KarthikKurapati/Keyboard-75/hardware/Keyboard.kicad_pcb

## KiCad design hardware/Keyboard.kicad_pcb (2026-01-09)

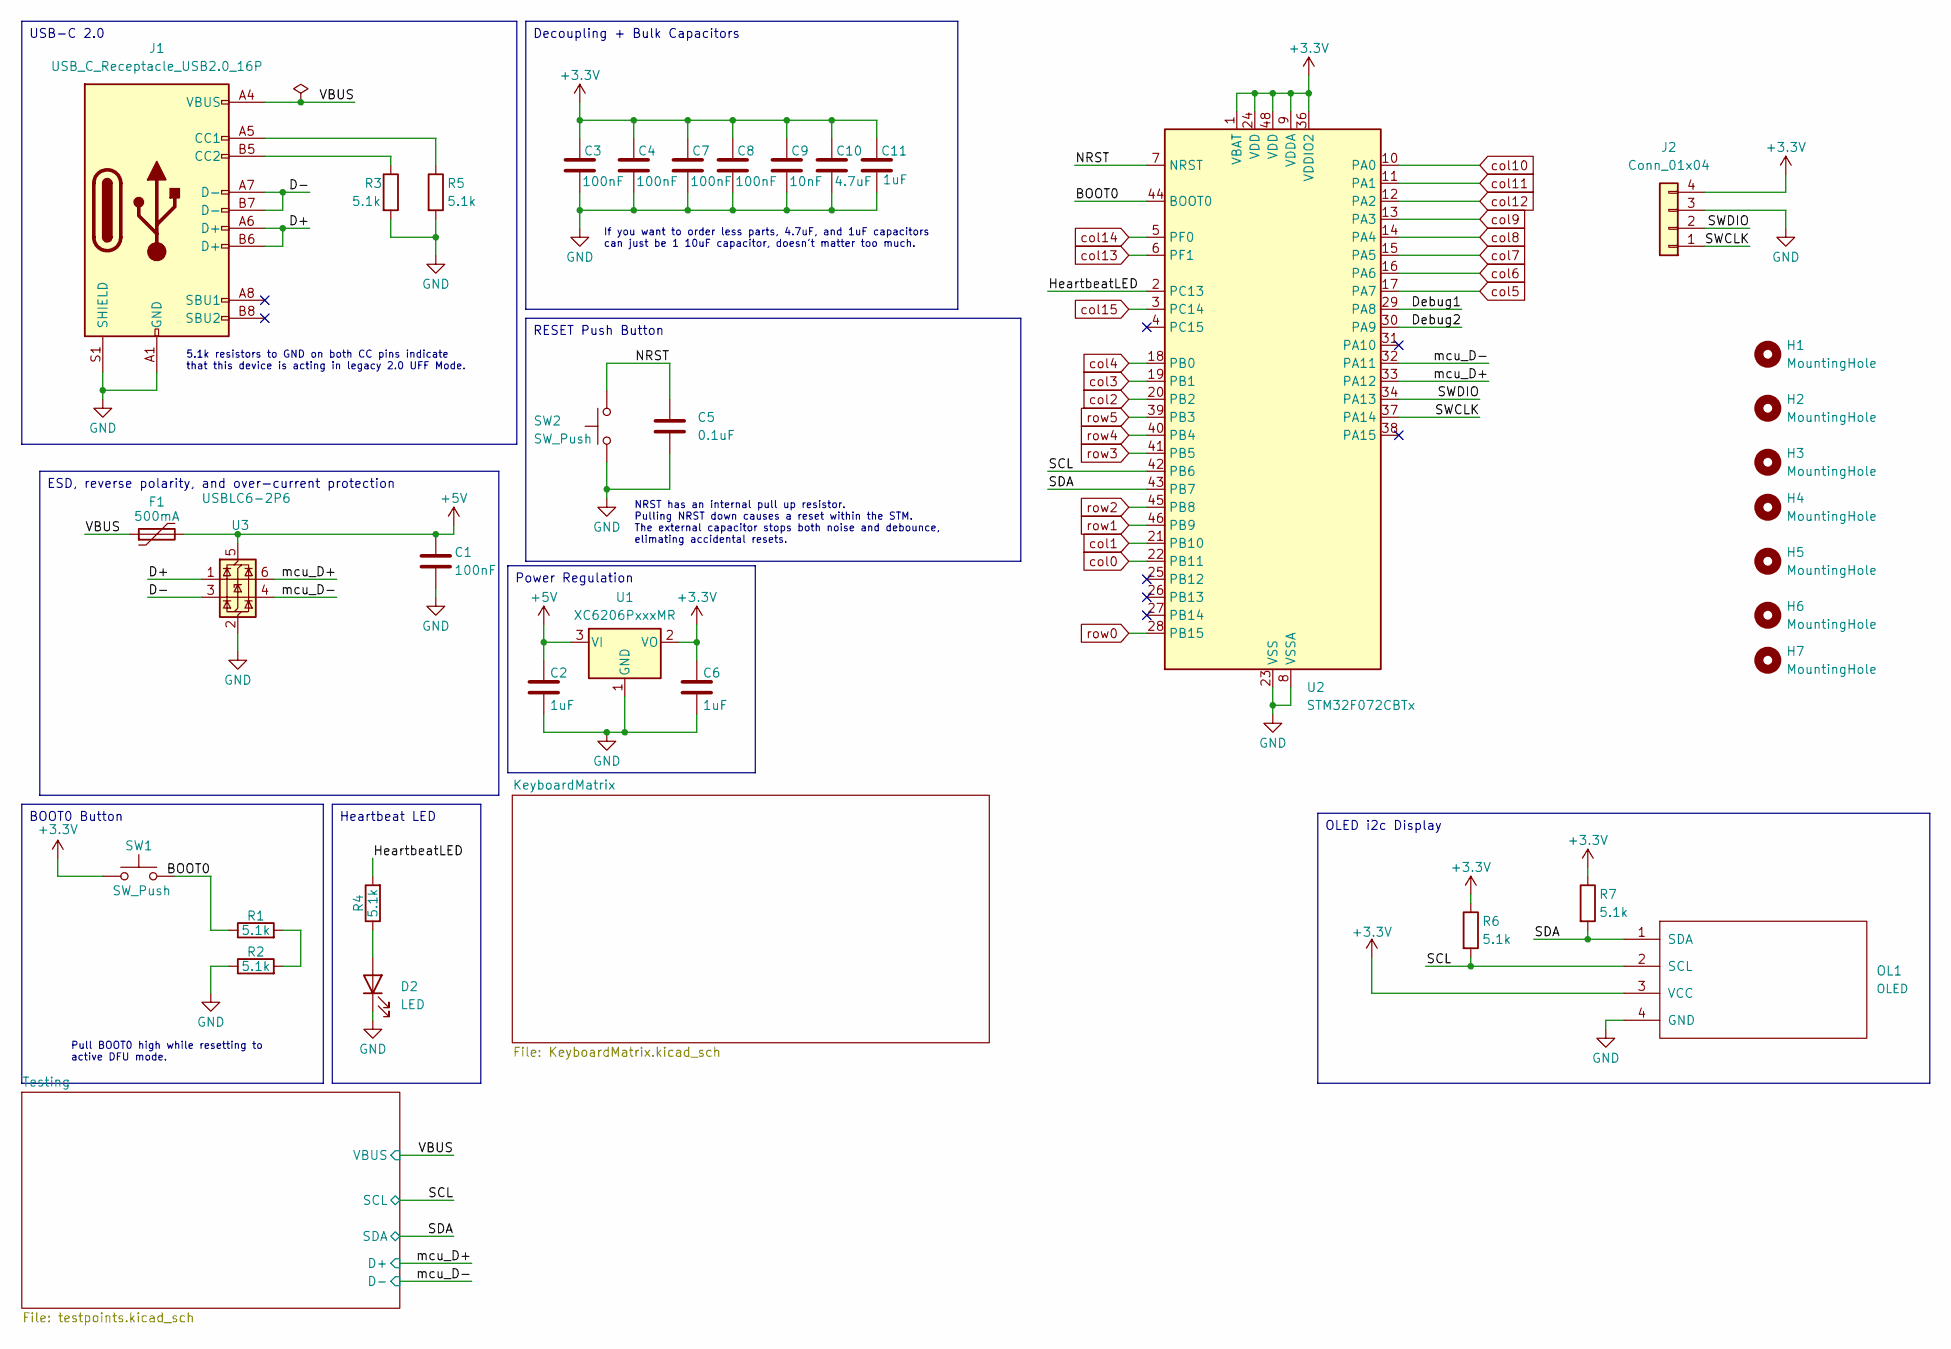
[picture p1: schematic Keyboard.kicad_sch]

Parts:
C1, C3, C4, C7, C8: 100nF; C_0603_1608Metric_Pad1.08x0.95mm_HandSolder
C2, C6, C11: 1uF; C_0603_1608Metric_Pad1.08x0.95mm_HandSolder
C5: 0.1uF; C_0603_1608Metric_Pad1.08x0.95mm_HandSolder
C9: 10nF; C_0603_1608Metric_Pad1.08x0.95mm_HandSolder
C10: 4.7uF; C_0603_1608Metric_Pad1.08x0.95mm_HandSolder
D2: LED; LED_0603_1608Metric_Pad1.05x0.95mm_HandSolder
F1: 500mA; Fuse_0603_1608Metric
H1, H2, H3, H4, H5, H6, H7: MountingHole; MountingHole_3.2mm_M3_ISO7380
J1: USB_C_Receptacle_USB2.0_16P; USB_C_Receptacle_GCT_USB4105-xx-A_16P_TopMnt_Horizontal
J2: Conn_01x04; PinHeader_1x04_P2.54mm_Vertical
OL1: OLED
R1, R2, R3, R4, R5, R6, R7: 5.1k; R_0603_1608Metric_Pad0.98x0.95mm_HandSolder
SW1, SW2: SW_Push; SW_Push_SPST_NO_Alps_SKRK
U1: XC6206PxxxMR; SOT-23-3
U2: STM32F072CBTx; LQFP-48_7x7mm_P0.5mm
U3: USBLC6-2P6; SOT-666

Connections:
+3.3V: C3.1, C4.1, C6.1, C7.1, C8.1, C9.1, C10.1, C11.1, J2.4, OL1.3 (VCC), R6.1, R7.1, SW1.1, U1.2 (VO), U2.1 (VBAT), U2.9 (VDDA), U2.24 (VDD), U2.36 (VDDIO2), U2.48 (VDD); also elsewhere on the board
+5V: C1.1, C2.1, F1.2, U1.3 (VI), U3.5 (VBUS); also elsewhere on the board
/BOOT0: R1.1, SW1.2, U2.44 (BOOT0)
/D+: J1.A6 (D+), J1.B6 (D+), U3.1 (I/O1)
/D-: J1.A7 (D-), J1.B7 (D-), U3.3 (I/O2)
/Debug1: U2.29 (PA8)
/Debug2: U2.30 (PA9)
/HeartbeatLED: R4.2, U2.2 (PC13)
/NRST: C5.1, SW2.2, U2.7 (NRST)
/SCL: OL1.2 (SCL), R6.2, U2.42 (PB6); also elsewhere on the board
/SDA: OL1.1 (SDA), R7.2, U2.43 (PB7); also elsewhere on the board
/SWCLK: J2.1, U2.37 (PA14)
/SWDIO: J2.2, U2.34 (PA13)
/VBUS: F1.1, J1.A4 (VBUS), J1.A9 (VBUS), J1.B4 (VBUS), J1.B9 (VBUS); also elsewhere on the board
/mcu_D+: U2.33 (PA12), U3.6 (I/O1); also elsewhere on the board
/mcu_D-: U2.32 (PA11), U3.4 (I/O2); also elsewhere on the board
GND: C1.2, C2.2, C3.2, C4.2, C5.2, C6.2, C7.2, C8.2, C9.2, C10.2, C11.2, D2.1 (K), J1.A1 (GND), J1.A12 (GND), J1.B1 (GND), J1.B12 (GND), J1.S1 (SHIELD), J2.3, OL1.4 (GND), R2.1, R3.2, R5.2, SW2.1, U1.1 (GND), U2.8 (VSSA), U2.23 (VSS), U2.35 (VSS), U2.47 (VSS), U3.2 (GND); also elsewhere on the board
unnamed: D2.2 (A), R4.1
unnamed: J1.A5 (CC1), R5.1
unnamed: J1.B5 (CC2), R3.1
unnamed: R1.2, R2.2
col0: U2.22 (PB11); also elsewhere on the board
col1: U2.21 (PB10); also elsewhere on the board
col2: U2.20 (PB2); also elsewhere on the board
col3: U2.19 (PB1); also elsewhere on the board
col4: U2.18 (PB0); also elsewhere on the board
col5: U2.17 (PA7); also elsewhere on the board
col6: U2.16 (PA6); also elsewhere on the board
col7: U2.15 (PA5); also elsewhere on the board
col8: U2.14 (PA4); also elsewhere on the board
col9: U2.13 (PA3); also elsewhere on the board
col10: U2.10 (PA0); also elsewhere on the board
col11: U2.11 (PA1); also elsewhere on the board
col12: U2.12 (PA2); also elsewhere on the board
col13: U2.6 (PF1); also elsewhere on the board
col14: U2.5 (PF0); also elsewhere on the board
col15: U2.3 (PC14); also elsewhere on the board
row0: U2.28 (PB15); also elsewhere on the board
row1: U2.46 (PB9); also elsewhere on the board
row2: U2.45 (PB8); also elsewhere on the board
row3: U2.41 (PB5); also elsewhere on the board
row4: U2.40 (PB4); also elsewhere on the board
row5: U2.39 (PB3); also elsewhere on the board

Notes on the sheet:
NRST has an internal pull up resistor. Pulling NRST down causes a reset within the STM. The external capacitor stops both noise and debounce, elimating accidental resets.
5.1k resistors to GND on both CC pins indicate that this device is acting in legacy 2.0 UFF Mode.
If you want to order less parts, 4.7uF, and 1uF capacitors can just be 1 10uF capacitor, doesn't matter too much.
Pull BOOT0 high while resetting to active DFU mode.
RESET Push Button
OLED i2c Display
ESD, reverse polarity, and over-current protection
BOOT0 Button
Power Regulation
Heartbeat LED
Decoupling + Bulk Capacitors
USB-C 2.0

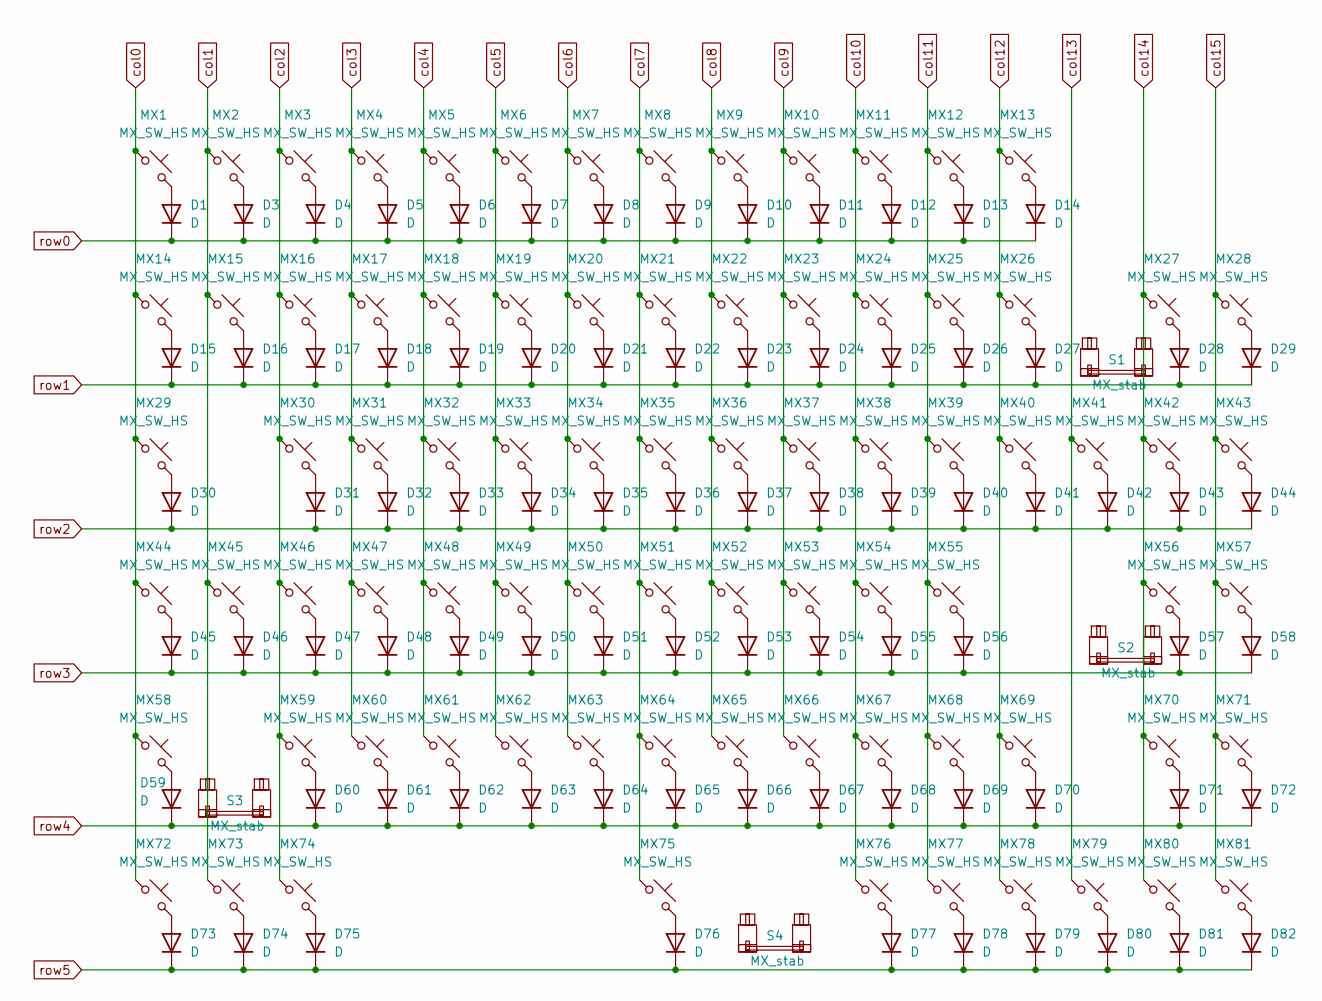
[picture p2: schematic KeyboardMatrix.kicad_sch]

Parts:
D1, D3, D4, D5, D6, D7, D8, D9, D10, D11, D12, D13, D14, D15, D16, D17, D18, D19, D20, D21, D22, D23, D24, D25, D26, D27, D28, D29, D30, D31, D32, D33, D34, D35, D36, D37, D38, D39, D40, D41, D42, D43, D44, D45, D46, D47, D48, D49, D50, D51, D52, D53, D54, D55, D56, D57, D58, D59, D60, D61, D62, D63, D64, D65, D66, D67, D68, D69, D70, D71, D72, D73, D74, D75, D76, D77, D78, D79, D80, D81, D82: D; D_SOD-123
MX1, MX2, MX3, MX4, MX5, MX6, MX7, MX8, MX9, MX10, MX11, MX12, MX13, MX14, MX15, MX16, MX17, MX18, MX19, MX20, MX21, MX22, MX23, MX24, MX25, MX26, MX27, MX28, MX29, MX30, MX31, MX32, MX33, MX34, MX35, MX36, MX37, MX38, MX39, MX40, MX41, MX42, MX43, MX44, MX45, MX46, MX47, MX48, MX49, MX50, MX51, MX52, MX53, MX54, MX55, MX56, MX57, MX58, MX59, MX60, MX61, MX62, MX63, MX64, MX65, MX66, MX67, MX68, MX69, MX70, MX71, MX72, MX73, MX74, MX75, MX76, MX77, MX78, MX79, MX80, MX81: MX_SW_HS; SW_MX_HS_CPG151101S11_1u
S1, S2, S3: MX_stab; STAB_MX_P_2u
S4: MX_stab; STAB_MX_P_6.25u

Connections:
unnamed: D1.2 (A), MX1.2
unnamed: D3.2 (A), MX2.2
unnamed: D4.2 (A), MX3.2
unnamed: D5.2 (A), MX4.2
unnamed: D6.2 (A), MX5.2
unnamed: D7.2 (A), MX6.2
unnamed: D8.2 (A), MX7.2
unnamed: D9.2 (A), MX8.2
unnamed: D10.2 (A), MX9.2
unnamed: D11.2 (A), MX10.2
unnamed: D12.2 (A), MX11.2
unnamed: D13.2 (A), MX12.2
unnamed: D14.2 (A), MX13.2
unnamed: D15.2 (A), MX14.2
unnamed: D16.2 (A), MX15.2
unnamed: D17.2 (A), MX16.2
unnamed: D18.2 (A), MX17.2
unnamed: D19.2 (A), MX18.2
unnamed: D20.2 (A), MX19.2
unnamed: D21.2 (A), MX20.2
unnamed: D22.2 (A), MX21.2
unnamed: D23.2 (A), MX22.2
unnamed: D24.2 (A), MX23.2
unnamed: D25.2 (A), MX24.2
unnamed: D26.2 (A), MX25.2
unnamed: D27.2 (A), MX26.2
unnamed: D28.2 (A), MX27.2
unnamed: D29.2 (A), MX28.2
unnamed: D30.2 (A), MX29.2
unnamed: D31.2 (A), MX30.2
unnamed: D32.2 (A), MX31.2
unnamed: D33.2 (A), MX32.2
unnamed: D34.2 (A), MX33.2
unnamed: D35.2 (A), MX34.2
unnamed: D36.2 (A), MX35.2
unnamed: D37.2 (A), MX36.2
unnamed: D38.2 (A), MX37.2
unnamed: D39.2 (A), MX38.2
unnamed: D40.2 (A), MX39.2
unnamed: D41.2 (A), MX40.2
unnamed: D42.2 (A), MX41.2
unnamed: D43.2 (A), MX42.2
unnamed: D44.2 (A), MX43.2
unnamed: D45.2 (A), MX44.2
unnamed: D46.2 (A), MX45.2
unnamed: D47.2 (A), MX46.2
unnamed: D48.2 (A), MX47.2
unnamed: D49.2 (A), MX48.2
unnamed: D50.2 (A), MX49.2
unnamed: D51.2 (A), MX50.2
unnamed: D52.2 (A), MX51.2
unnamed: D53.2 (A), MX52.2
unnamed: D54.2 (A), MX53.2
unnamed: D55.2 (A), MX54.2
unnamed: D56.2 (A), MX55.2
unnamed: D57.2 (A), MX56.2
unnamed: D58.2 (A), MX57.2
unnamed: D59.2 (A), MX58.2
unnamed: D60.2 (A), MX59.2
unnamed: D61.2 (A), MX60.2
unnamed: D62.2 (A), MX61.2
unnamed: D63.2 (A), MX62.2
unnamed: D64.2 (A), MX63.2
unnamed: D65.2 (A), MX64.2
unnamed: D66.2 (A), MX65.2
unnamed: D67.2 (A), MX66.2
unnamed: D68.2 (A), MX67.2
unnamed: D69.2 (A), MX68.2
unnamed: D70.2 (A), MX69.2
unnamed: D71.2 (A), MX70.2
unnamed: D72.2 (A), MX71.2
unnamed: D73.2 (A), MX72.2
unnamed: D74.2 (A), MX73.2
unnamed: D75.2 (A), MX74.2
unnamed: D76.2 (A), MX75.2
unnamed: D77.2 (A), MX76.2
unnamed: D78.2 (A), MX77.2
unnamed: D79.2 (A), MX78.2
unnamed: D80.2 (A), MX79.2
unnamed: D81.2 (A), MX80.2
unnamed: D82.2 (A), MX81.2
col0: MX1.1, MX14.1, MX29.1, MX44.1, MX58.1, MX72.1; also elsewhere on the board
col1: MX2.1, MX15.1, MX45.1, MX73.1; also elsewhere on the board
col2: MX3.1, MX16.1, MX30.1, MX46.1, MX59.1, MX74.1; also elsewhere on the board
col3: MX4.1, MX17.1, MX31.1, MX47.1, MX60.1; also elsewhere on the board
col4: MX5.1, MX18.1, MX32.1, MX48.1, MX61.1; also elsewhere on the board
col5: MX6.1, MX19.1, MX33.1, MX49.1, MX62.1; also elsewhere on the board
col6: MX7.1, MX20.1, MX34.1, MX50.1, MX63.1; also elsewhere on the board
col7: MX8.1, MX21.1, MX35.1, MX51.1, MX64.1, MX75.1; also elsewhere on the board
col8: MX9.1, MX22.1, MX36.1, MX52.1, MX65.1; also elsewhere on the board
col9: MX10.1, MX23.1, MX37.1, MX53.1, MX66.1; also elsewhere on the board
col10: MX11.1, MX24.1, MX38.1, MX54.1, MX67.1, MX76.1; also elsewhere on the board
col11: MX12.1, MX25.1, MX39.1, MX55.1, MX68.1, MX77.1; also elsewhere on the board
col12: MX13.1, MX26.1, MX40.1, MX69.1, MX78.1; also elsewhere on the board
col13: MX41.1, MX79.1; also elsewhere on the board
col14: MX27.1, MX42.1, MX56.1, MX70.1, MX80.1; also elsewhere on the board
col15: MX28.1, MX43.1, MX57.1, MX71.1, MX81.1; also elsewhere on the board
row0: D1.1 (K), D3.1 (K), D4.1 (K), D5.1 (K), D6.1 (K), D7.1 (K), D8.1 (K), D9.1 (K), D10.1 (K), D11.1 (K), D12.1 (K), D13.1 (K), D14.1 (K); also elsewhere on the board
row1: D15.1 (K), D16.1 (K), D17.1 (K), D18.1 (K), D19.1 (K), D20.1 (K), D21.1 (K), D22.1 (K), D23.1 (K), D24.1 (K), D25.1 (K), D26.1 (K), D27.1 (K), D28.1 (K), D29.1 (K); also elsewhere on the board
row2: D30.1 (K), D31.1 (K), D32.1 (K), D33.1 (K), D34.1 (K), D35.1 (K), D36.1 (K), D37.1 (K), D38.1 (K), D39.1 (K), D40.1 (K), D41.1 (K), D42.1 (K), D43.1 (K), D44.1 (K); also elsewhere on the board
row3: D45.1 (K), D46.1 (K), D47.1 (K), D48.1 (K), D49.1 (K), D50.1 (K), D51.1 (K), D52.1 (K), D53.1 (K), D54.1 (K), D55.1 (K), D56.1 (K), D57.1 (K), D58.1 (K); also elsewhere on the board
row4: D59.1 (K), D60.1 (K), D61.1 (K), D62.1 (K), D63.1 (K), D64.1 (K), D65.1 (K), D66.1 (K), D67.1 (K), D68.1 (K), D69.1 (K), D70.1 (K), D71.1 (K), D72.1 (K); also elsewhere on the board
row5: D73.1 (K), D74.1 (K), D75.1 (K), D76.1 (K), D77.1 (K), D78.1 (K), D79.1 (K), D80.1 (K), D81.1 (K), D82.1 (K); also elsewhere on the board

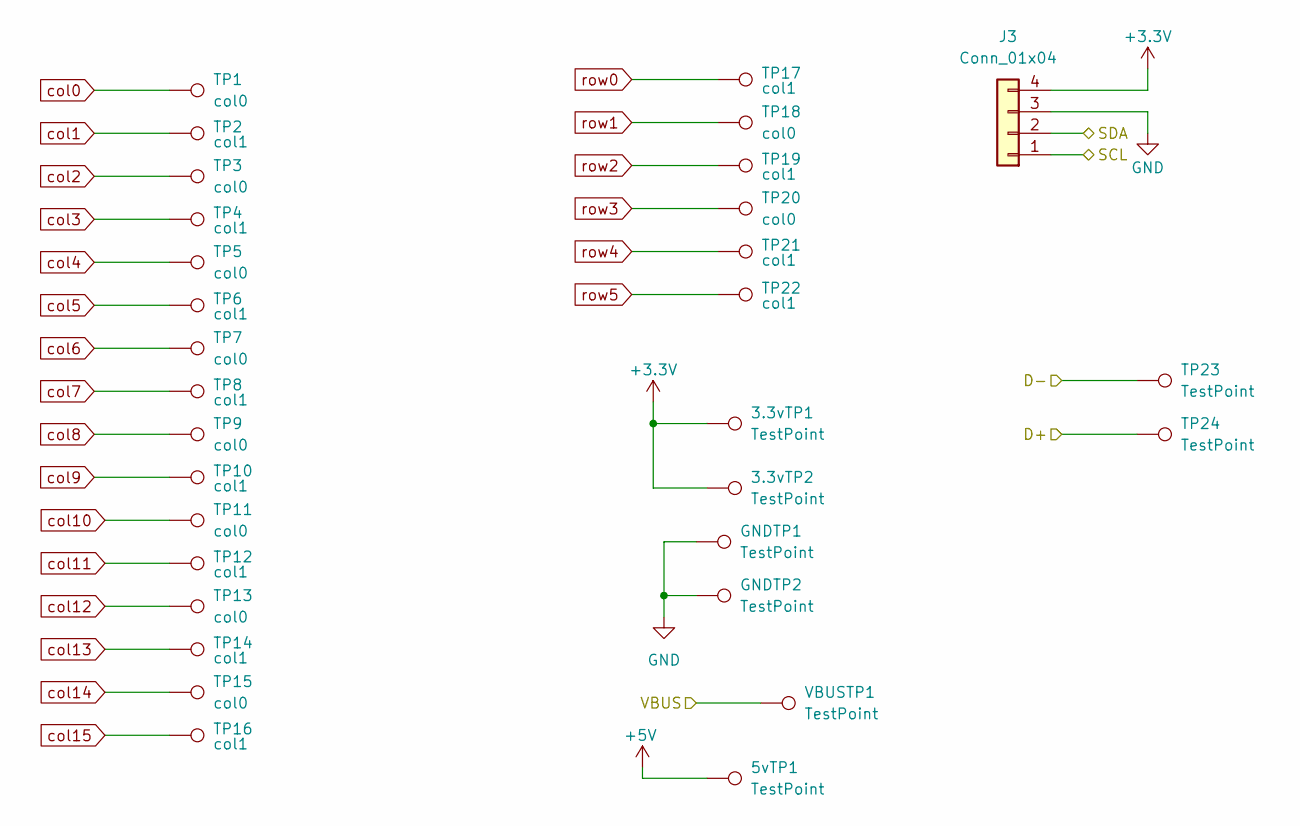
[picture p3: schematic testpoints.kicad_sch]

Parts:
3.3vTP1, 3.3vTP2, 5vTP1: TestPoint; TestPoint_Pad_2.0x2.0mm
GNDTP1, GNDTP2: TestPoint; TestPoint_Pad_2.0x2.0mm
J3: Conn_01x04; PinHeader_1x04_P2.54mm_Vertical
TP1, TP3, TP5, TP7, TP9, TP11, TP13, TP15, TP18, TP20: col0; TestPoint_Pad_2.0x2.0mm
TP2, TP4, TP6, TP8, TP10, TP12, TP14, TP16, TP17, TP19, TP21, TP22: col1; TestPoint_Pad_2.0x2.0mm
TP23, TP24: TestPoint; TestPoint_THTPad_1.0x1.0mm_Drill0.5mm
VBUSTP1: TestPoint; TestPoint_Pad_2.0x2.0mm

Connections:
+3.3V: 3.3vTP1.1, 3.3vTP2.1, J3.4; also elsewhere on the board
+5V: 5vTP1.1; also elsewhere on the board
/SCL: J3.1; also elsewhere on the board
/SDA: J3.2; also elsewhere on the board
/VBUS: VBUSTP1.1; also elsewhere on the board
/mcu_D+: TP24.1; also elsewhere on the board
/mcu_D-: TP23.1; also elsewhere on the board
GND: GNDTP1.1, GNDTP2.1, J3.3; also elsewhere on the board
col0: TP1.1; also elsewhere on the board
col1: TP2.1; also elsewhere on the board
col2: TP3.1; also elsewhere on the board
col3: TP4.1; also elsewhere on the board
col4: TP5.1; also elsewhere on the board
col5: TP6.1; also elsewhere on the board
col6: TP7.1; also elsewhere on the board
col7: TP8.1; also elsewhere on the board
col8: TP9.1; also elsewhere on the board
col9: TP10.1; also elsewhere on the board
col10: TP11.1; also elsewhere on the board
col11: TP12.1; also elsewhere on the board
col12: TP13.1; also elsewhere on the board
col13: TP14.1; also elsewhere on the board
col14: TP15.1; also elsewhere on the board
col15: TP16.1; also elsewhere on the board
row0: TP17.1; also elsewhere on the board
row1: TP18.1; also elsewhere on the board
row2: TP19.1; also elsewhere on the board
row3: TP20.1; also elsewhere on the board
row4: TP21.1; also elsewhere on the board
row5: TP22.1; also elsewhere on the board

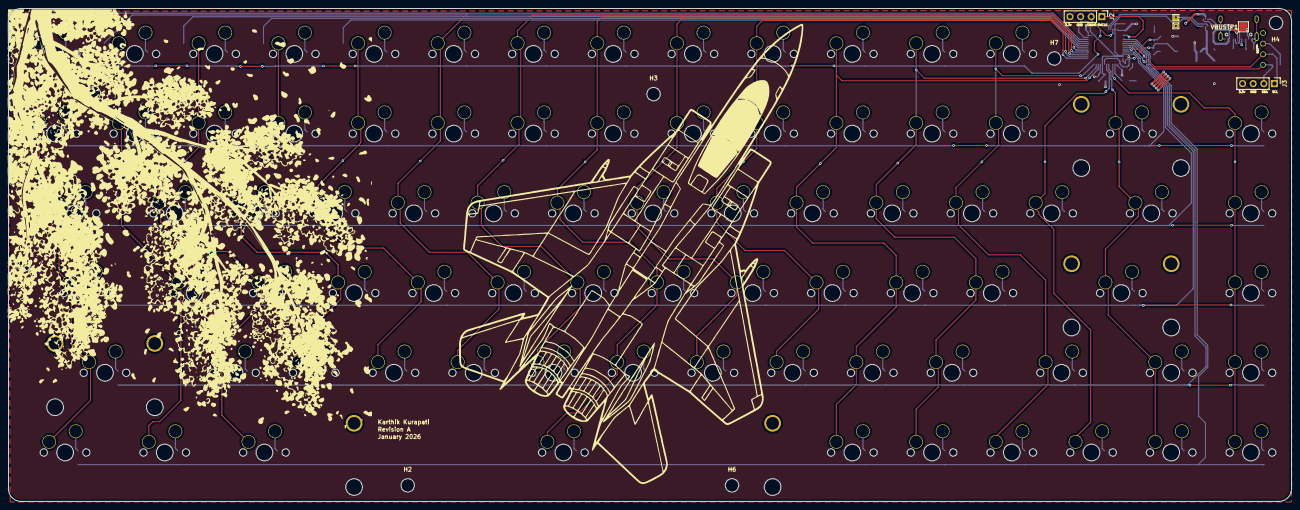
[picture p4: board Keyboard.kicad_pcb from above]

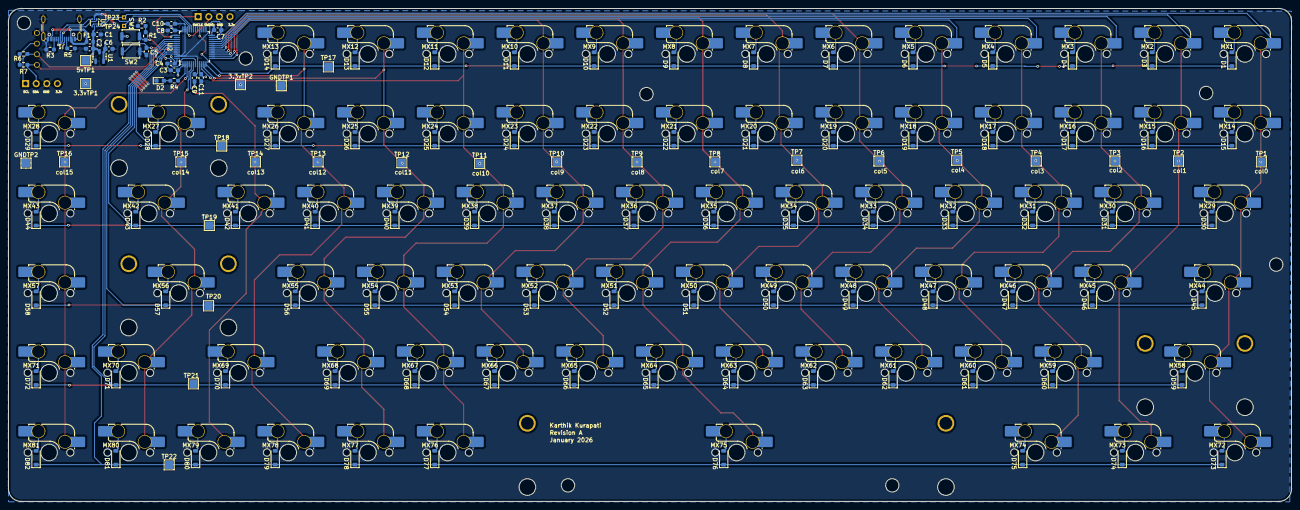
[picture p5: board Keyboard.kicad_pcb from below]

Board: 2 copper layers, 306.6 x 117.8 mm, 232 parts (215 on the bottom side), 122 nets.
