KarthikKurapati/Keyboard-75/(commit log)

2025-12-25 inital commit
    [Keyboard.kicad_pcb, Keyboard.kicad_sch, KeyboardMatrix.kicad_sch]
2025-12-26 stm32layout done, started routing board
    [Keyboard.kicad_pcb, Keyboard.kicad_sch, KeyboardMatrix.kicad_sch]
2025-12-26 finished routing --> need to add test points and add i2c display. also need to request a review and refine routing.
    [Keyboard.kicad_pcb, Keyboard.kicad_sch, KeyboardMatrix.kicad_sch]
2025-12-29 added OLED display + new libary for it
    things to add:
    test points
    3.3v, 5v LED
    fix some wiring
    [Keyboard.kicad_sch]
2025-12-30 added testpoints, need to readd library
    [Keyboard.kicad_pcb, Keyboard.kicad_sch, KeyboardMatrix.kicad_sch, testpoints.kicad_sch]
2025-12-30 ready for review!
    [Keyboard.kicad_pcb]
2026-01-09 production files added --> ready for assembly
    [Keyboard-B_Cu.gbr, Keyboard-B_Mask.gbr, Keyboard-B_Paste.gbr, Keyboard-B_Silkscreen.gbr, Keyboard-Edge_Cuts.gbr, Keyboard-F_Cu.gbr, Keyboard-F_Mask.gbr, Keyboard-F_Paste.gbr]
